kloper/uv-timer/timer.kicad_pcb

## KiCad design timer.kicad_pcb (2016-09-15)

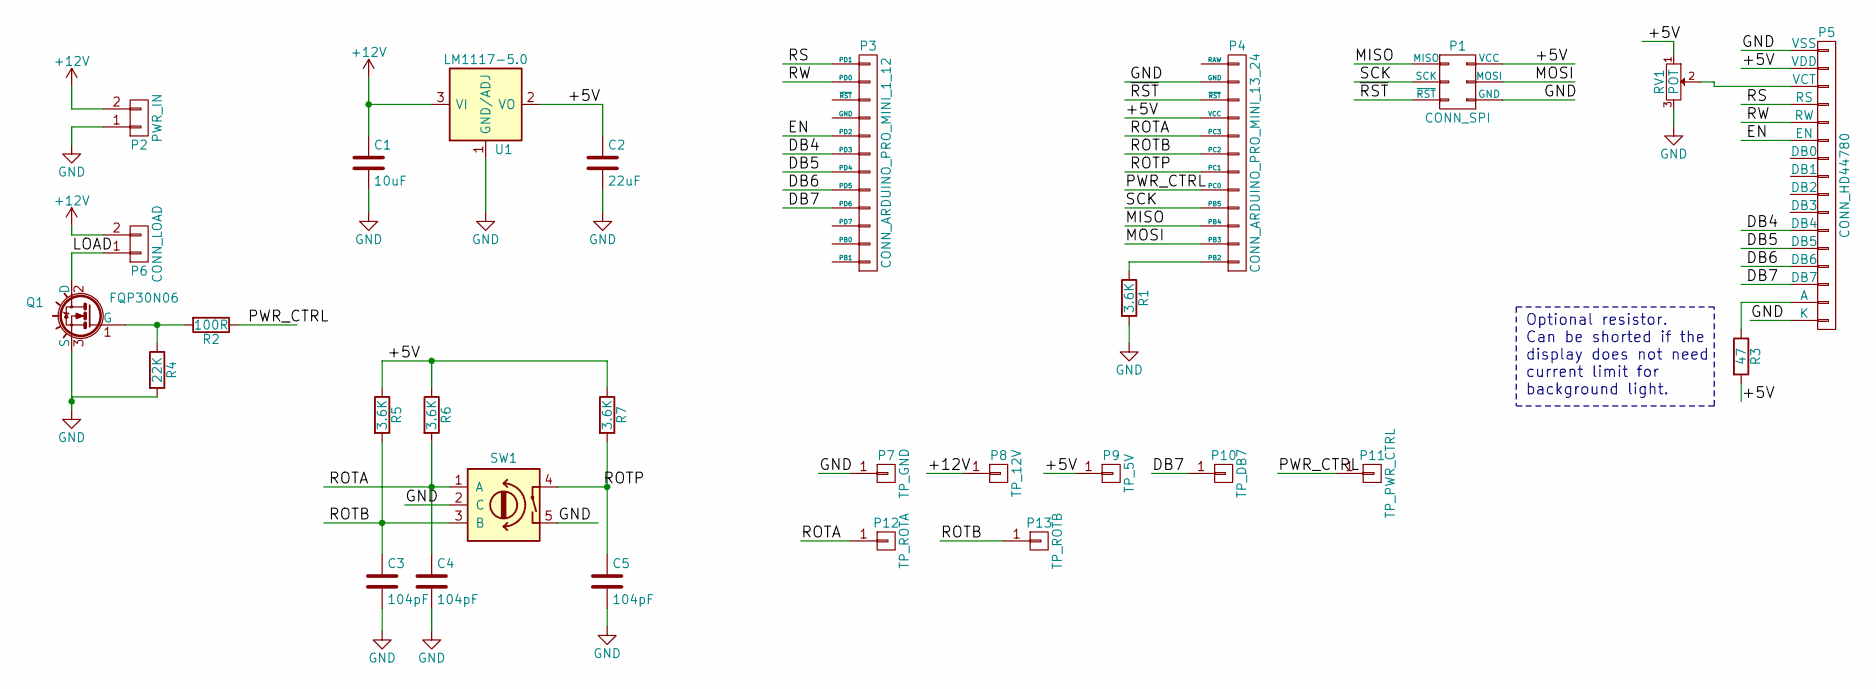
[picture p1: schematic timer.sch, Timer based on Arduino Pro Mini]

Parts:
C1: 10uF; C_Disc_D3_P2.5
C2: 22uF; C_Disc_D3_P2.5
C3, C4, C5: 104pF; C_Disc_D3_P2.5
P1: CONN_SPI; Pin_Header_Straight_2x03
P2: PWR_IN; Socket_Strip_Straight_1x02
P3: CONN_ARDUINO_PRO_MINI_1_12
P4: CONN_ARDUINO_PRO_MINI_13_24; Socket_Strip_Straight_1x12
P5: CONN_HD44780; Socket_Strip_Straight_1x16
P6: CONN_LOAD; Pin_Header_Straight_1x02
P7: TP_GND; Pin_Header_Straight_1x01
P8: TP_12V; Pin_Header_Straight_1x01
P9: TP_5V; Pin_Header_Straight_1x01
P10: TP_DB7; Pin_Header_Straight_1x01
P11: TP_PWR_CTRL; Pin_Header_Straight_1x01
P12: TP_ROTA; Pin_Header_Straight_1x01
P13: TP_ROTB; Pin_Header_Straight_1x01
Q1: FQP30N06; TO-220
R1, R5, R6, R7: 3.6K; Resistor_Horizontal_RM12mm
R2: 100R; Resistor_Horizontal_RM12mm
R3: 47; Resistor_Horizontal_RM12mm
R4: 22K; Resistor_Horizontal_RM12mm
RV1: POT; Potentiometer_Trimmer-Suntan-TSR-3386C
SW1: ROTARY_ENCODER_SWITCH; Pin_Header_Straight_2x03
U1: LM1117-5.0; SOT-223

Connections:
+12V: C1.1, P2.2, P6.2, P8.1, U1.3 (VI)
/+5V: C2.1, P1.2 (VCC), P4.4 (VCC), P5.2 (VDD), P9.1, R3.2, R5.1, R6.1, R7.1, RV1.1, U1.2 (VO), U1.4 (VO)
/DB4: P3.6 (PD3), P5.11 (DB4)
/DB5: P3.7 (PD4), P5.12 (DB5)
/DB6: P3.8 (PD5), P5.13 (DB6)
/DB7: P3.9 (PD6), P5.14 (DB7), P10.1
/EN: P3.5 (PD2), P5.6 (EN)
/LOAD: P6.1, Q1.2 (D)
/MISO: P1.1 (MISO), P4.10 (PB4)
/MOSI: P1.4 (MOSI), P4.11 (PB3)
/PWR_CTRL: P4.8 (PC0), P11.1, R2.1
/ROTA: C4.1, P4.5 (PC3), P12.1, R6.2, SW1.1 (A)
/ROTB: C3.1, P4.6 (PC2), P13.1, R5.2, SW1.3 (B)
/ROTP: C5.1, P4.7 (PC1), R7.2, SW1.4
/RS: P3.1 (PD1), P5.4 (RS)
/RW: P3.2 (PD0), P5.5 (RW)
/SCK: P1.3 (SCK), P4.9 (PB5)
/~RST: P1.5 (~RST), P4.3 (~RST)
GND: C1.2, C2.2, C3.2, C4.2, C5.2, P1.6 (GND), P2.1, P4.2 (GND), P5.1 (VSS), P5.16 (K), P7.1, Q1.3 (S), R1.2, R4.2, RV1.3, SW1.2 (C), SW1.5, U1.1 (GND/ADJ)
unnamed: P4.12 (PB2), R1.1
unnamed: P5.3 (VCT), RV1.2
unnamed: P5.15 (A), R3.1
unnamed: Q1.1 (G), R2.2, R4.1

Notes on the sheet:
Optional resistor. Can be shorted if the display does not need current limit for background light.

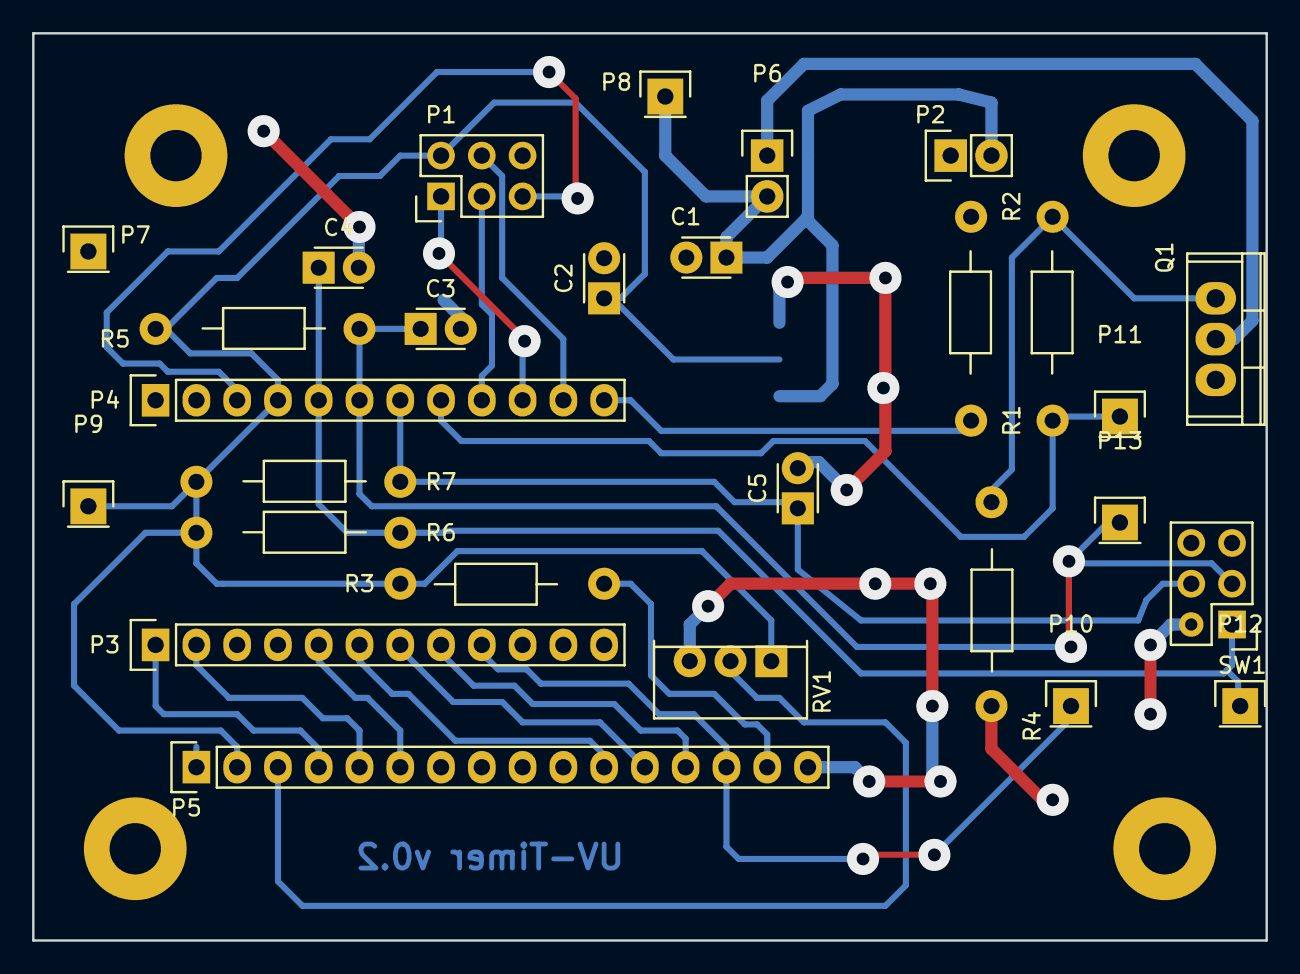
[picture p2: board timer.kicad_pcb from above]

Board: 2 copper layers, 76.8 x 56.5 mm, 29 parts (1 on the bottom side), 23 nets.
