kloper/uv-timer/(commit log)

2016-09-09 Initial import of UV Timer KiCad project and initial firmware.
    [timer.kicad_pcb, timer.sch]
2016-09-10 Introduced rotary switch driver
    The driver is based on edge detection interrupt and a timer for
    delayed input sampling to get rid of ringing.
2016-09-11 Fixed F_CPU frequency value to the real one
    [config.h]
2016-09-11 Introduced the basic real time timer and minimal terminal UI layer
2016-09-12 Compile with printf_min library
    Required for later uv_counter_t formatting
2016-09-12 Fix wrong backward focus setting
    This is due to wrong interpretation of C modulo operator
    which seems to work more like reminder operator.
    [term.c]
2016-09-12 Implement mode change and part of starting/stopping
    The change_mode() function is populated and changes frame layout
    depending on current mode.
    Start and Stop buttons are now behave as expected.
2016-09-14 Fix frame resetting when stopping timer
    [main.c]
2016-09-14 Created timer alarm and actual count down
2016-09-14 Removed bug notification from schematics...
    ...it is already fixed.
    [timer.sch]
2016-09-15 Make timer save current alarm value in EEPROM
    The value is saved on start of countdown and retrieved at boot time.
    This is usability feature.
2016-09-15 Fix remaining_value calculation...
    ... that can go negative if the timer stopped manually.
    [main.c]
2016-09-15 Unset alarm on stop of countdown
    This is required when stopping timer manually
2016-09-15 Make remaining value the current alarm value if stopped manually
2016-09-15 Minor fixes in kicad project
    [timer.kicad_pcb, timer.sch]
